garthwebb/grinder-controller/Coffee Grinder.pdf

# Coffee Grinder State Diagram

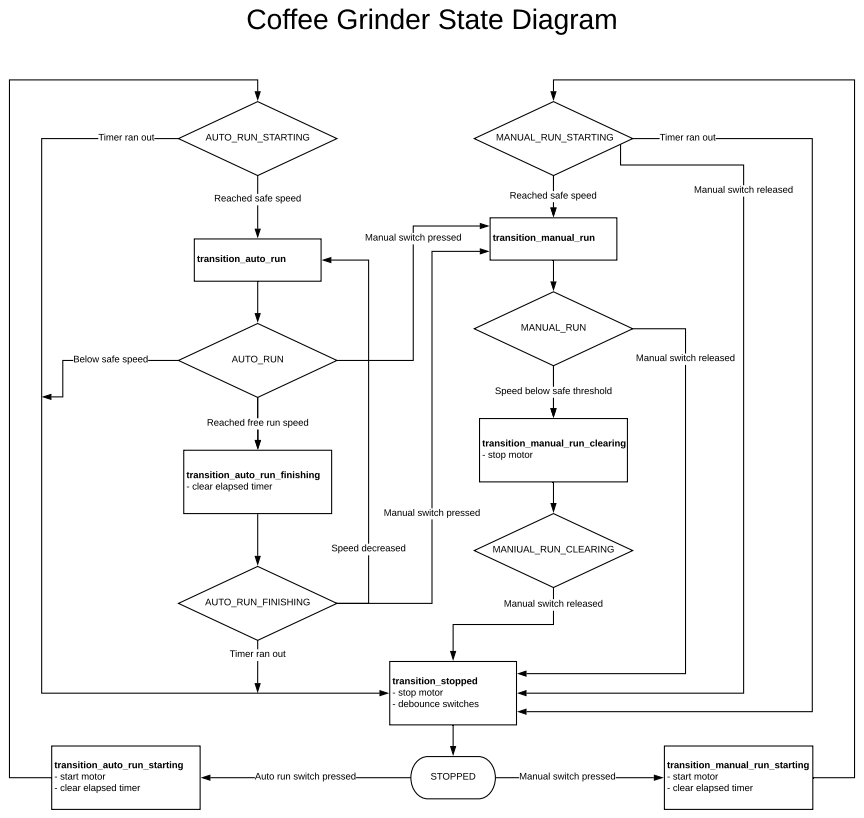
[picture p1: page 1]
STOPPED; AUTO_RUN_STARTING; AUTO_RUN; AUTO_RUN_FINISHING; MANUAL_RUN_STARTING; MANUAL_RUN; MANIUAL_RUN_CLEARING; Speed decreased; transition_stopped - stop motor - debounce switches; transition_auto_run; transition_manual_run; transition_manual_run_clearing - stop motor; Reached safe speed; Manual switch released

Timer ran out

Reached safe speed

Manual switch pressed

Below safe speed

Manual switch released

Speed below safe threshold

Reached free run speed

transition_auto_run_finishing
- clear elapsed timer

transition_auto_run_starting
- start motor

transition_manual_run_starting

Auto run switch pressed
