garthwebb/grinder-controller/pcb-layout/controller.brd

## EAGLE design pcb-layout/controller.brd (2019-02-07)

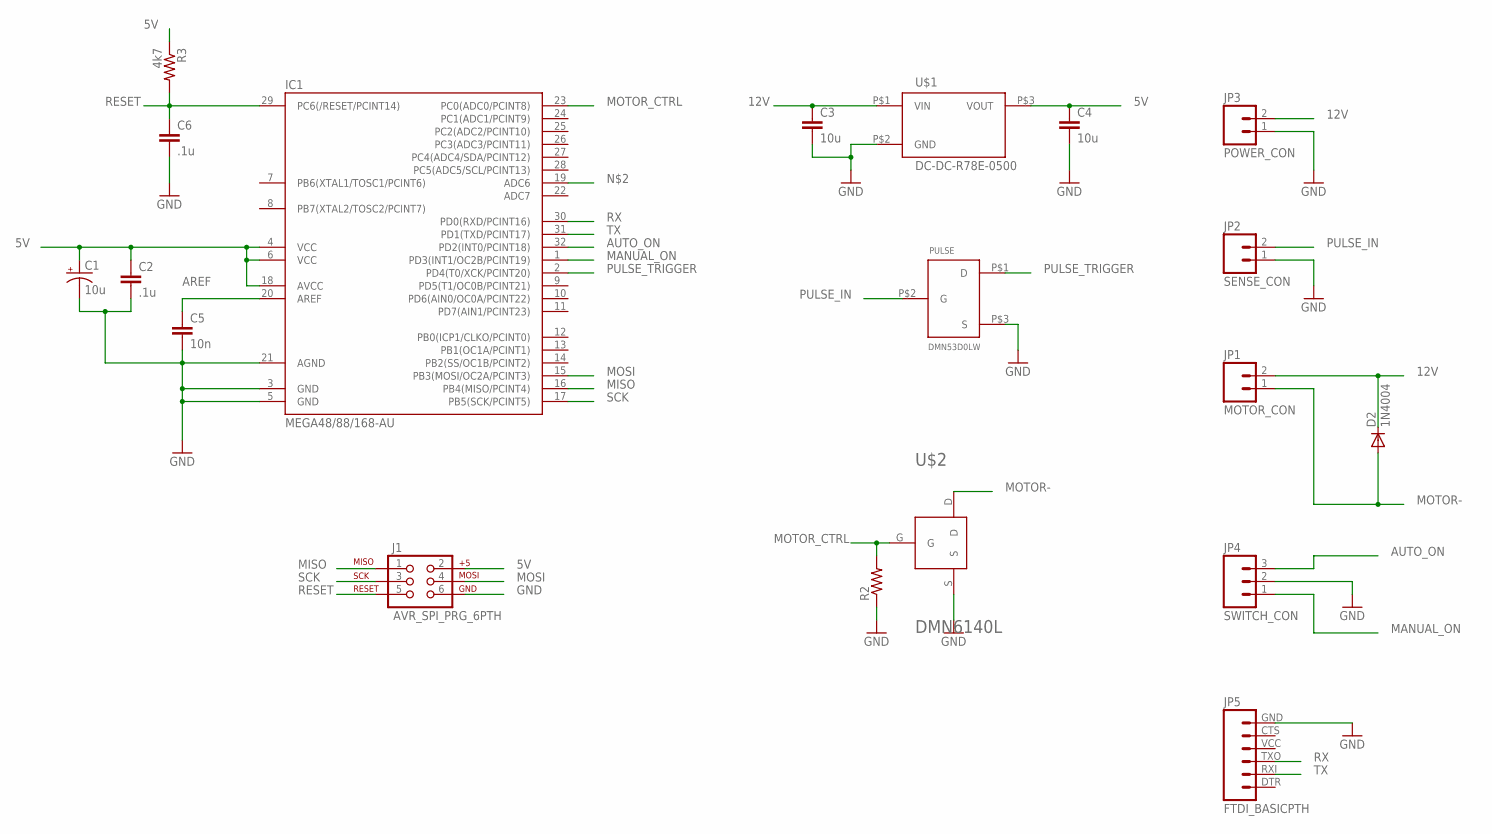
[picture p2: schematic controller.sch]

Parts:
C1: 10u; EIA3216
C2, C6: .1u; 0805
C3, C4: 10u; 0805
C5: 10n; 0805
D2: 1N4004; DO41-10
IC1: MEGA48/88/168-AU; TQFP32-08
J1: AVR_SPI_PRG_6PTH; 2X3
JP1: MOTOR_CON; 1X02_LONGPADS
JP2: SENSE_CON; 1X02_LONGPADS
JP3: POWER_CON; 1X02_LONGPADS
JP4: SWITCH_CON; 1X03_NO_SILK
JP5: FTDI_BASICPTH; FTDI_BASIC
PULSE: DMN53D0LW; SOT-323
R2: RESISTOR1206; 1206
R3: 4k7; 1206
U$1: DC-DC-R78E-0500
U$2: DMN6140L; SOT-32-DIODES

Connections:
5V: C1.A (+), C2.1, C4.1, IC1.4 (VCC), IC1.6 (VCC), IC1.18 (AVCC), J1.2, R3.1, U$1.P$3 (VOUT)
12V: C3.1, D2.C, JP1.2, JP3.2, U$1.P$1 (VIN)
AREF: C5.1, IC1.20 (AREF)
AUTO_ON: IC1.32 (PD2(INT0/PCINT18)), JP4.3
GND: C1.C (-), C2.2, C3.2, C4.2, C5.2, C6.2, IC1.3 (GND), IC1.5 (GND), IC1.21 (AGND), J1.6, JP2.1, JP3.1, JP4.2, JP5.GND (6), PULSE.P$3 (S), R2.1, U$1.P$2 (GND), U$2.S
MANUAL_ON: IC1.1 (PD3(INT1/OC2B/PCINT19)), JP4.1
MISO: IC1.16 (PB4(MISO/PCINT4)), J1.1
MOSI: IC1.15 (PB3(MOSI/OC2A/PCINT3)), J1.4
MOTOR-: D2.A, JP1.1, U$2.D
MOTOR_CTRL: IC1.23 (PC0(ADC0/PCINT8)), R2.2, U$2.G
PULSE_IN: JP2.2, PULSE.P$2 (G)
PULSE_TRIGGER: IC1.2 (PD4(T0/XCK/PCINT20)), PULSE.P$1 (D)
RESET: C6.1, IC1.29 (PC6(/RESET/PCINT14)), J1.5, R3.2
RX: IC1.30 (PD0(RXD/PCINT16)), JP5.TXO (3)
SCK: IC1.17 (PB5(SCK/PCINT5)), J1.3
TX: IC1.31 (PD1(TXD/PCINT17)), JP5.RXI (2)

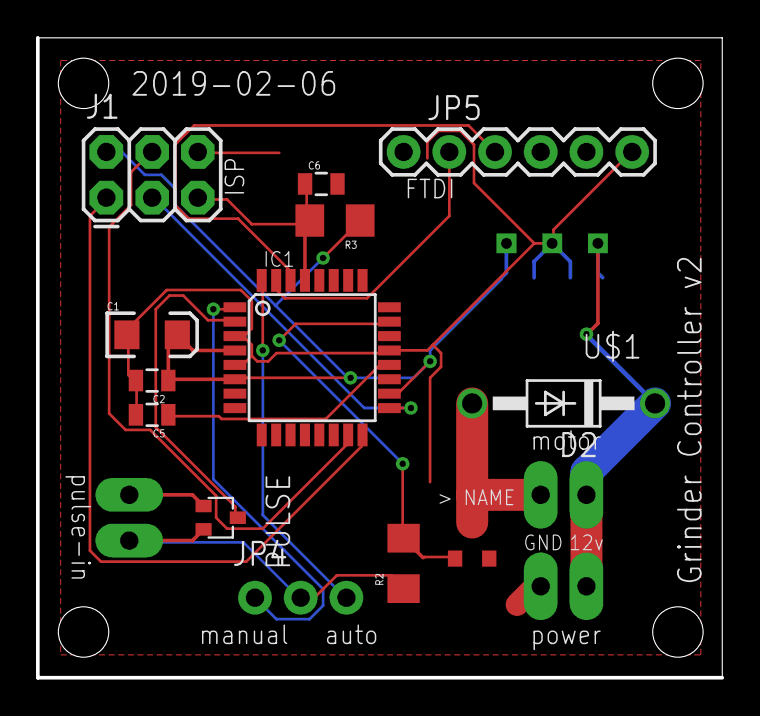
[picture p3: board controller.brd from above]

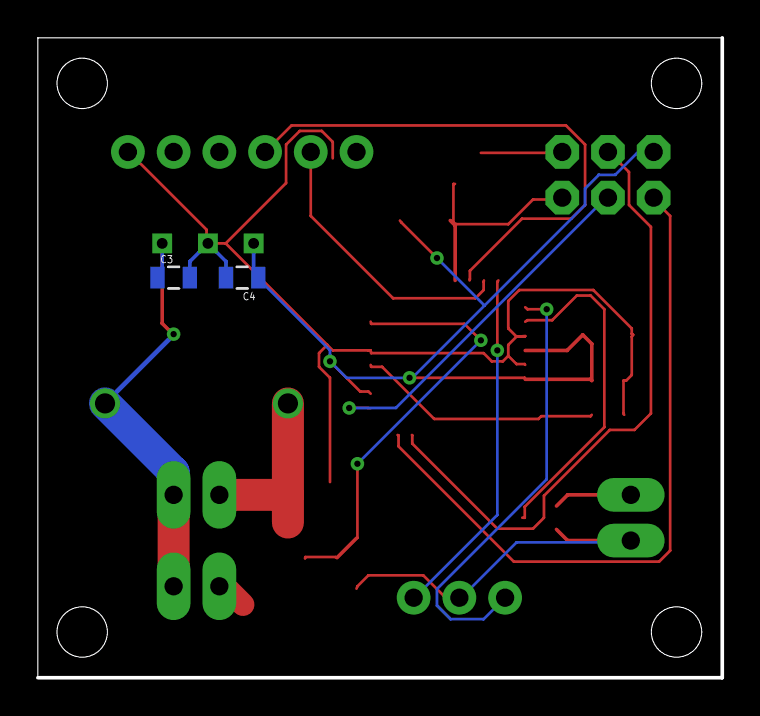
[picture p4: board controller.brd from below]

Board: 2 copper layers, 38.0 x 35.5 mm, 19 parts (2 on the bottom side), 16 nets.
