garthwebb/grinder-controller/(commit log)

2018-02-26 Remove uneeded LED blinking code
2018-02-27 Speed detection and switch monitoring (test) working
2018-03-05 Add the eagle files for the controller
    [controller.brd, controller.csv, controller.sch]
2019-02-07 Updated board to fix a number of problems
    * Used DMN53D0LW layout for the DMN6140L part which has a smaller footprint. Created a new layout for DMN6140L and used that
    * Removed resistor in series with flyback diode.
    * Updated diode layout to be 1N4004 compatible
    * Removed diode across FET (was there assuming it would be a BJT)
    * Fixed reset resistor, attaching it to VCC rather than GND
    * Added a cap from reset to ground
    * Fixed motor PWM output pin from ADC6 (not for pwm output) to ADC0
    [controller.brd, controller.sch]
